Traveler0014/word-clock/hardware/preview/real-right.jpg

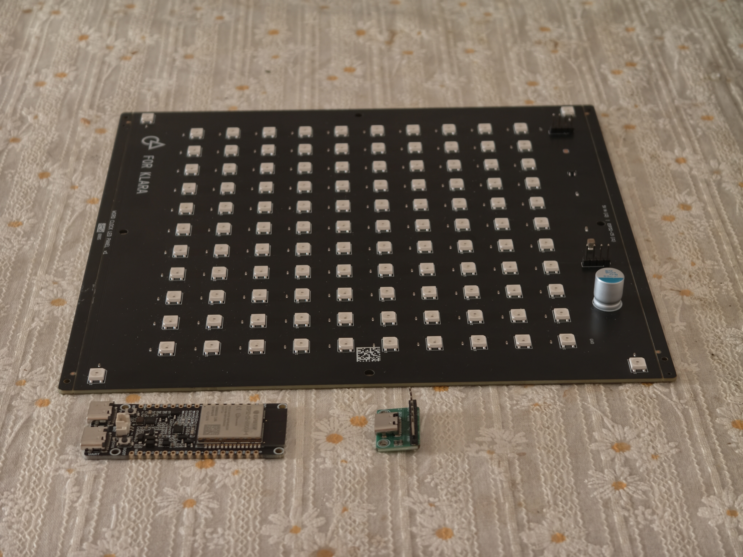
hardware/preview/real-right.jpg
