Traveler0014/word-clock/hardware/preview/real-top.jpg

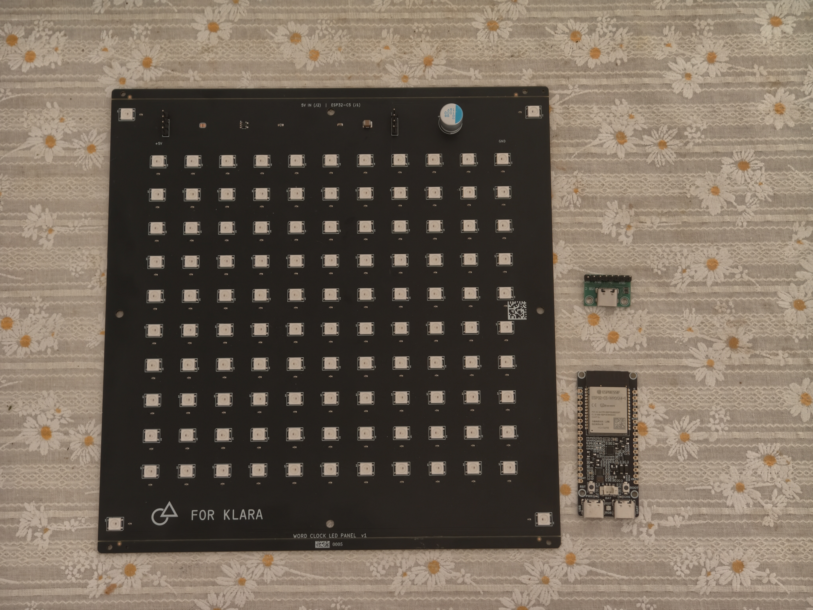
hardware/preview/real-top.jpg
