Traveler0014/word-clock/firmware/README.md

# word-clock-firmware

字钟固件（路线 A：Rust std on ESP-IDF）。**MVP 已实机点亮**。开发流程见 [docs/development.md](../docs/development.md)。

## 结构

```
firmware/
├── app/              # ESP32-C5 固件 bin（esp-idf-svc）
│   ├── src/
│   │   ├── main.rs       # 启动流程：自检 → 延迟 → WiFi → SNTP → 显示循环
│   │   ├── leddrv.rs     # WS2812B RMT 驱动封装（GPIO4，1/4 亮度限幅，自检，整帧刷新）
│   │   ├── wifi.rs       # STA 连接（WPA2、扫描确认、无限重试）
│   │   └── time_svc.rs   # SNTP（ntp.aliyun.com）+ 时区 UTC+8
│   └── sdkconfig.defaults    # UART0 主控制台、主任务栈 16K（各项有注释）
├── wordclock-core/   # 纯逻辑：时间 → LED 点阵。no_std，宿主机可测，路线B 直接复用
├── tools/uart_sniff.py   # UART 日志监听（自动重连）
├── vendor/ws2812-esp32-rmt-driver/  # vendored 驱动（适配 hal 0.46 的补丁版）
├── .cargo/config.toml        # 目标芯片 / IDF 版本 / sdkconfig 指定
└── env.sh            # 注入 IDF + esp 工具链环境
```

> 各源文件的模块级文档（`//!`）与关键行注释承载实现细节，**改代码时同步维护注释**，不要把细节搬进 README。

## 版本锁定（已验证组合，勿随意升级）

- `esp-idf-svc 0.52` / `esp-idf-hal 0.46` + **vendored** `ws2812-esp32-rmt-driver`（hal 0.46 补丁版，legacy rmt api）
- **IDF v5.5.1**（esp-idf-sys managed 安装在 `firmware/.embuild/`）
  - v6.0.2：esp-idf-sys 0.36 未适配，且 eim 的 python 环境残缺
  - hal 0.45：对 esp32c5 支持不全且与 v5.4+ API 漂移
- esp Rust 工具链 1.95.0（nightly fork，`build-std` 编译 std）

## mDNS / 组件仓库

局域网域名访问（`http://klara-clock.local/`）靠 **组件仓库的 `espressif/mdns`**：IDF v5.5
已把 mdns 从内置组件移出，本仓库通过 `app/Cargo.toml` 的
`[package.metadata.esp-idf-sys] extra_components` 声明，esp-idf-sys 会生成
`idf_component.yml` 交给 IDF 组件管理器。

- 版本锁定在 `firmware/components_esp32c5.lock`（当前 1.15.1），与 `Cargo.lock` 一样应提交
- **首次构建需访问 `components.espressif.com`**（拉下来后缓存在 `.embuild/` 与 `target/`，后续离线可编）
- 坑：本工作区是**虚拟 workspace**，`cargo metadata` 拿不到 root package，esp-idf-sys
  会**静默忽略** `[package.metadata.esp-idf-sys]`（只打一条 warning 就继续，表现为
  “配了没效果”、`out/main/idf_component.yml` 根本没生成）。必须在
  `firmware/.cargo/config.toml` 里设 `ESP_IDF_SYS_ROOT_CRATE = "word-clock"`
- hostname 与 DHCP option 12 共用设置项（`settings.name`）；服务实例名固定
  `KLARA Clock`，通告 `_http._tcp` 80
- Android 原生不解析 `.local`（需额外 App），iOS/macOS/Windows/Linux(Avahi) 可直接用

## 板子差异（务必确认！）

| 模组 | flash | PSRAM | 本仓库配置 |
| --- | --- | --- | --- |
| **ESP32-C5-WROOM-1-N32R8**（2026-10 起的新板） | 32MB | 8MB | 当前 `app/sdkconfig.defaults` 的目标 |
| ESP32-C5-WROOM-1-N16R8（旧板） | 16MB | 8MB | 需删掉 `CONFIG_ESPTOOLPY_FLASHSIZE_32MB` |

flash 相关配置（`app/sdkconfig.defaults` 有逐条注释，别随手改回默认值）：

- `CONFIG_ESPTOOLPY_FLASHSIZE_32MB=y` —— 默认值是 2MB，与实物不符时 app 镜像头的 flash size 错误
- `CONFIG_ESPTOOLPY_FLASHFREQ_40M=y` —— **红线**：N32R8 在 DIO 80MHz 下取指不可靠，
  release 全量 app 会在 `call_start_cpu0 → esp_mmu_map_init`（flash 时钟切换后执行的第一段
  flash 常驻代码）拿到非法指令，打印 `Guru Meditation (Illegal instruction)` 后无限重启。
  诡异之处：debug 版和小体积的 `--features diag` 版不触发，只有 release 全量包中招——
  排查时别被“debug 能跑”骗了。
- 分区表 `app/partitions.csv`：factory 4MB（默认 singleapp 只有 1MB，装不下 1.46MB 的 release 包）。
  esp-idf-sys 无法把自定义 CSV 交给 IDF 的 CMake，所以由 espflash 直接消费，烧录命令见 `AGENTS.md`。

## 网络

构建（凭据不进固件，首次上电经配网页面写入 NVS，详见 docs/development.md）：

```bash
cargo build -p word-clock   # 不需要 WiFi 凭据：首次上电用配网页面写入
```

国内构建加速（IDF 组件/GitHub 资产代理）如需，参考：

```bash
GIT_CONFIG_COUNT=1 \
GIT_CONFIG_KEY_0='url.https://gh-proxy.com/https://github.com/.insteadOf' \
GIT_CONFIG_VALUE_0='https://github.com/' \
IDF_GITHUB_ASSETS='dl.espressif.com/github_assets' \
cargo build -p word-clock
```
