Traveler0014/word-clock/enclosure/stl/pcb_v4/preview/all_iso.png

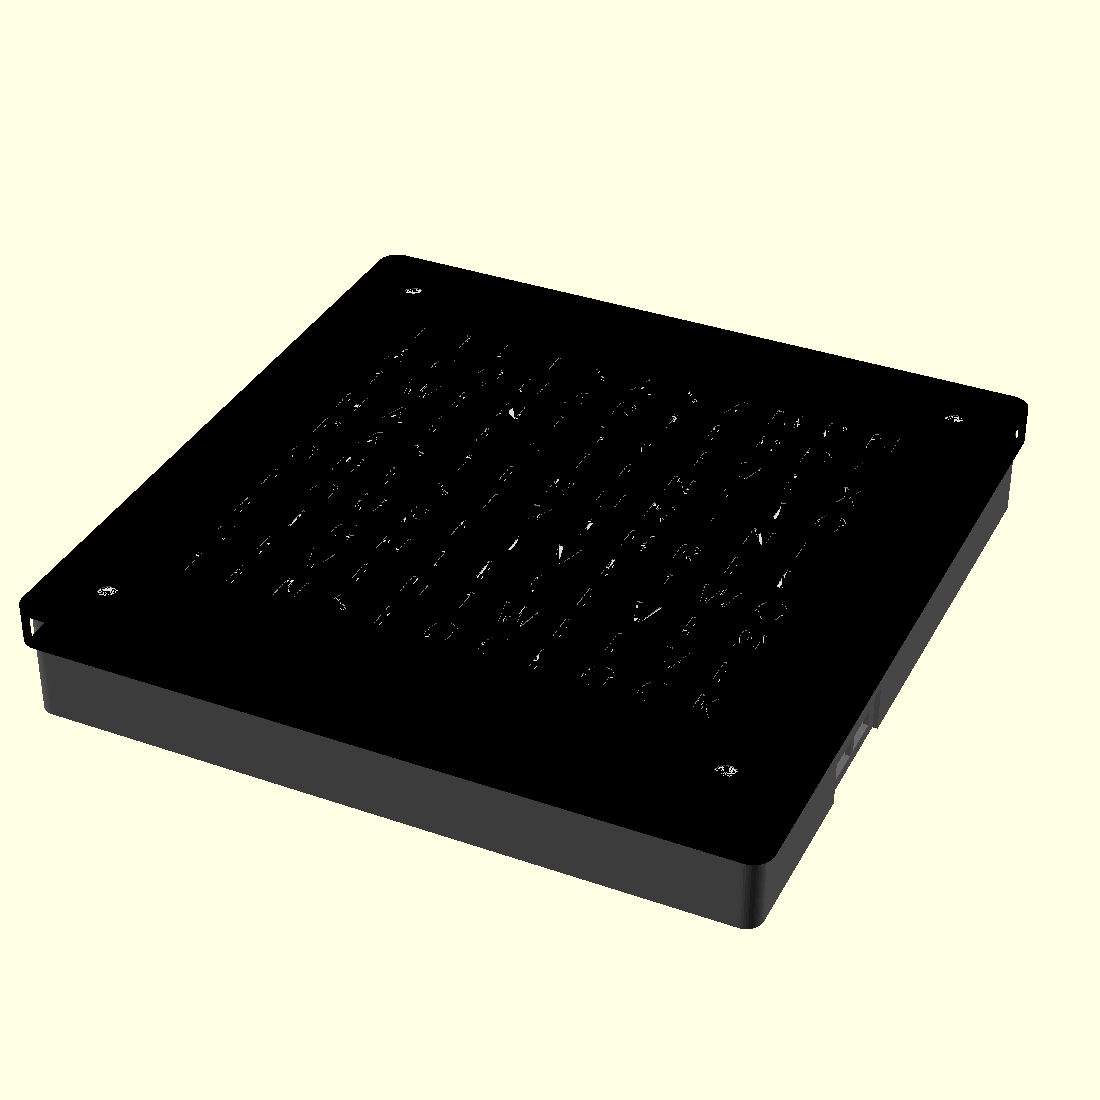
enclosure/stl/pcb_v4/preview/all_iso.png
