Traveler0014/word-clock/enclosure/stl/pcb_v4/preview/body_iso.png

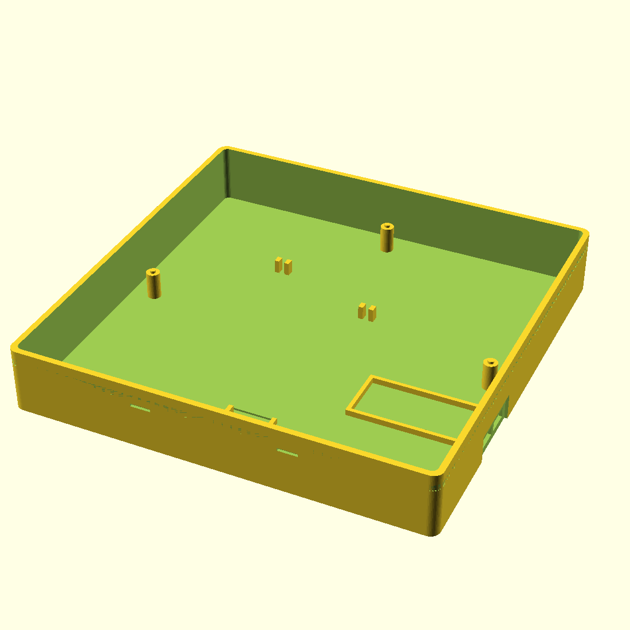
enclosure/stl/pcb_v4/preview/body_iso.png
