Traveler0014/word-clock/enclosure/stl/pcb_v4/preview/coupon.png

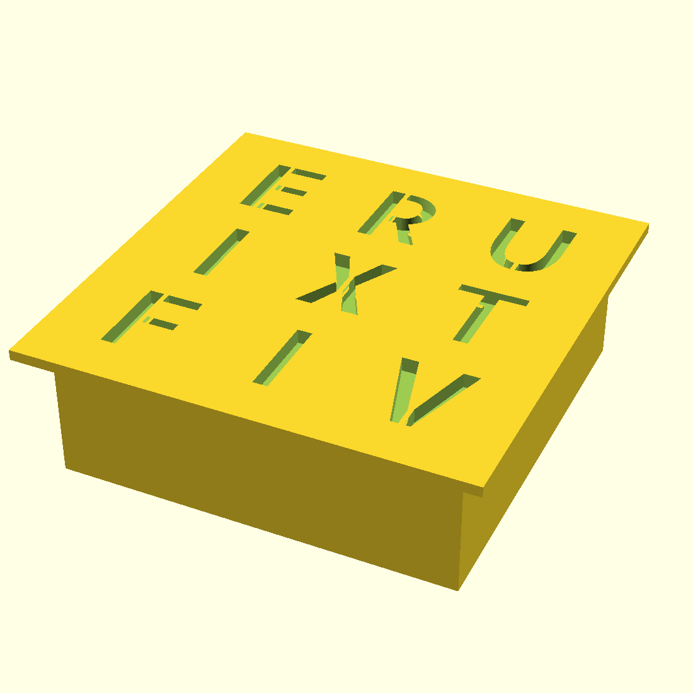
enclosure/stl/pcb_v4/preview/coupon.png
