Traveler0014/word-clock/enclosure/stl/preview/backplate.png

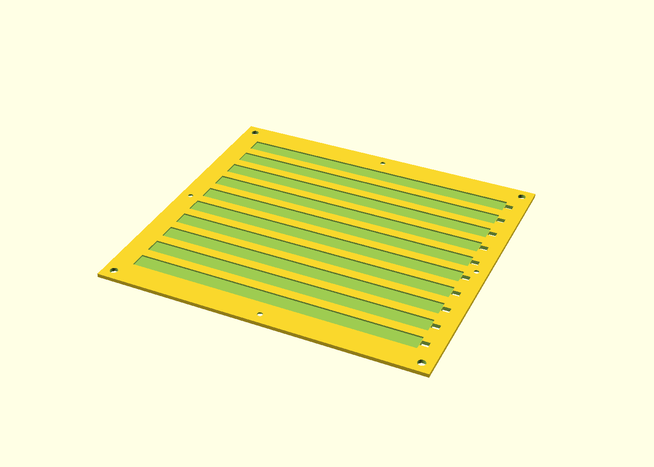
enclosure/stl/preview/backplate.png
