Traveler0014/word-clock/enclosure/stl/preview/corner_ring.png

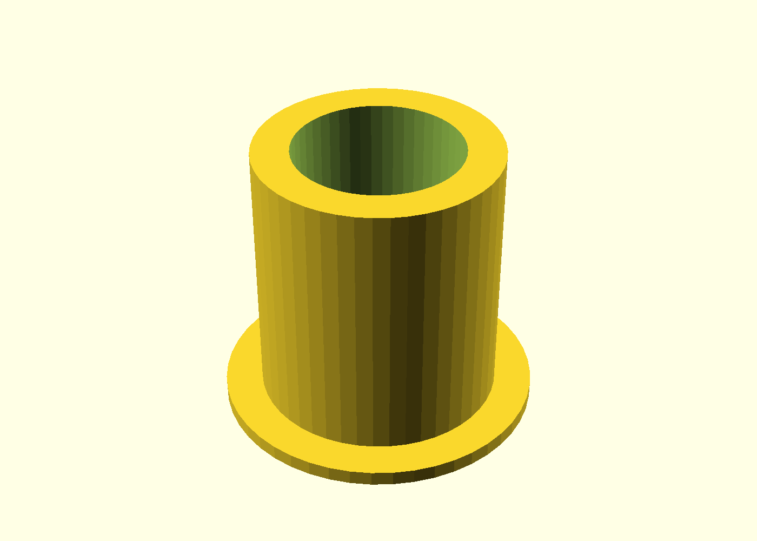
enclosure/stl/preview/corner_ring.png
