Traveler0014/word-clock/enclosure/stl/preview/faceplate_allerta_front.png

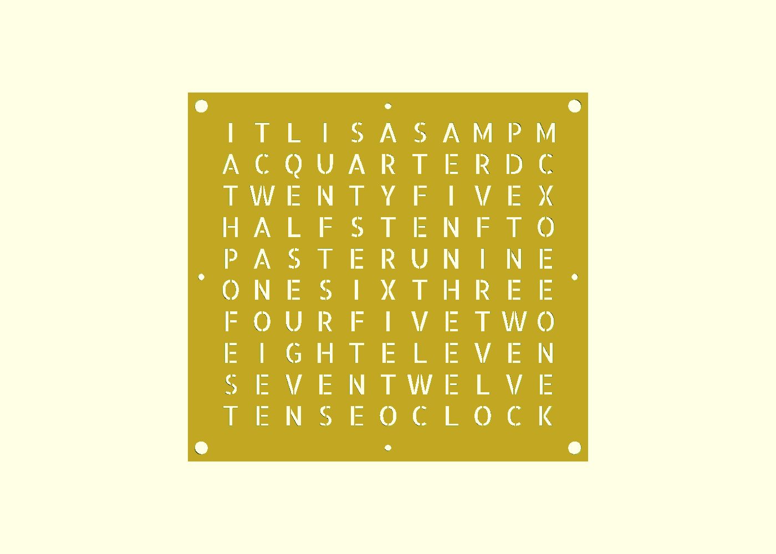
enclosure/stl/preview/faceplate_allerta_front.png
