Traveler0014/word-clock/enclosure/stl/preview/pitch_jig.png

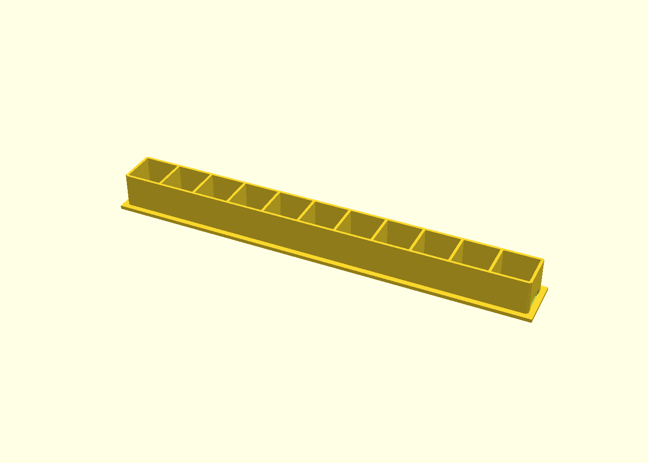
enclosure/stl/preview/pitch_jig.png
