Traveler0014/word-clock/hardware/preview/pcb_bottom.png

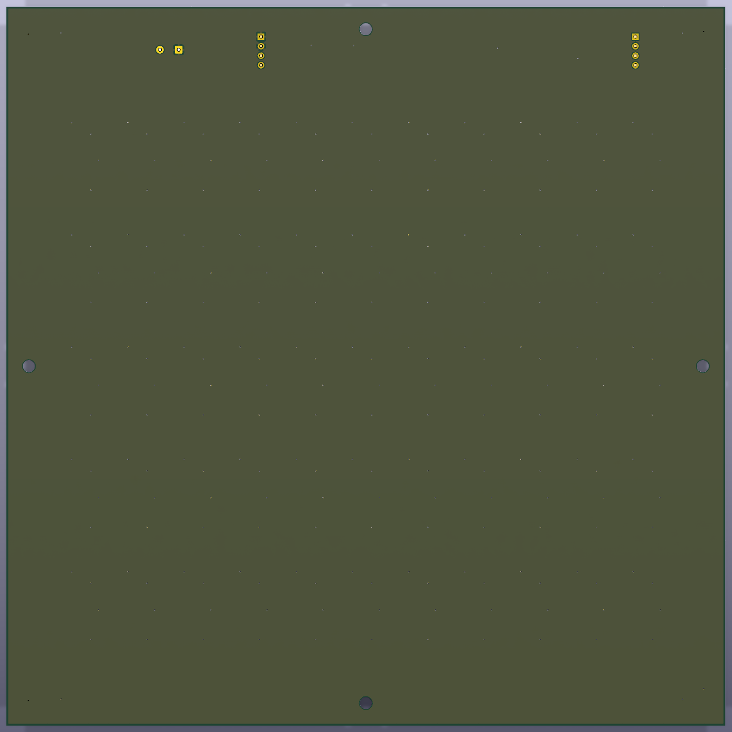
hardware/preview/pcb_bottom.png
