Traveler0014/word-clock/hardware/preview/pcb_top.png

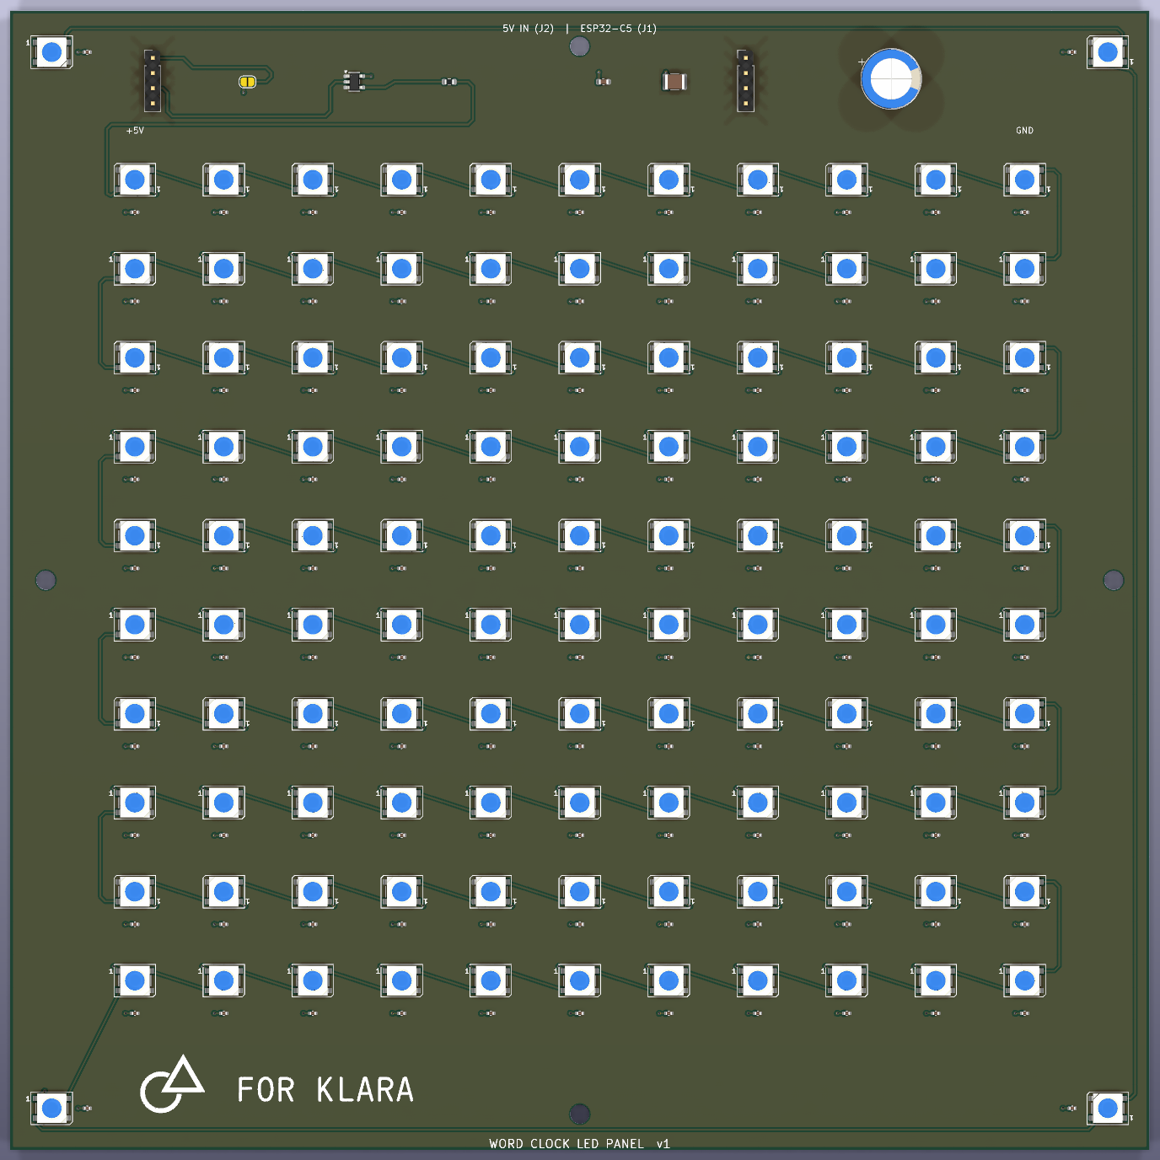
hardware/preview/pcb_top.png
