Traveler0014/word-clock/hardware/preview/real-front.jpg

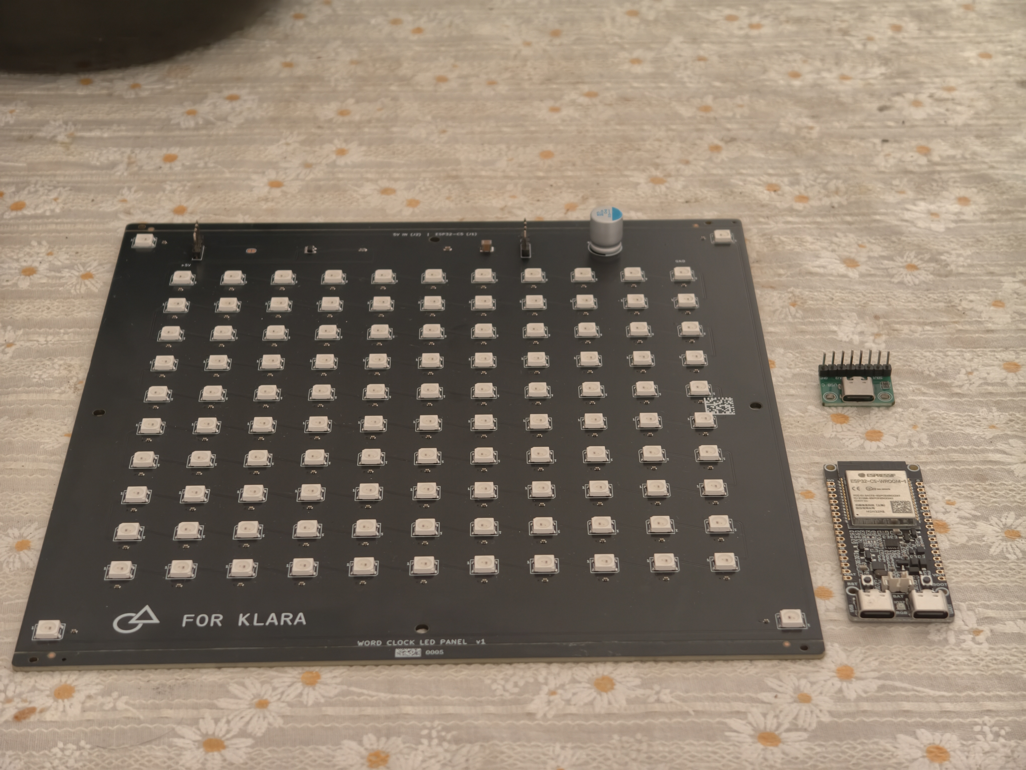
hardware/preview/real-front.jpg
