Traveler0014/word-clock/docs/bom.md

# BOM 物料清单

## 已有

| 物料 | 规格 | 备注 |
|---|---|---|
| ESP32-C5-DevKit | 双 USB 口：UART（CH9102F）= 日志主控，USB-JTAG = 烧录/调试 | 双线常驻，详见 docs/development.md |
| WS2812B 灯条 | 60灯/米 | 需 114 颗 ≈ 1.9m |
| 拓竹 3D 打印机 | 250×250×250 | 结构件 |

## 待购

| 物料 | 规格建议 | 用途 | 参考价 |
|---|---|---|---|
| 5V 电源 | 5V/4A + DC 母座（或 USB-C PD 诱骗 5V 模块） | 供电 | ¥20-40 |
| 电平转换 | 74AHCT125 或 74HCT245 | 3.3V→5V 数据线 | ¥2 |
| 电容 | 1000µF/16V 电解 | 灯条电源缓冲 | ¥1 |
| 电阻 | 470Ω ×1 | 数据线串联 | ¥0.1 |
| 光敏电阻 | GL5528 + 10kΩ 分压电阻 | 自动亮度 | ¥2 |
| DS3231 RTC 模块 | 可选 | 断网/断电守时 | ¥8 |
| 电线 | 22AWG 硅胶线（红黑+信号色） | 行间/供电 | ¥10 |
| 洞洞板或打样 PCB | 小尺寸 | 电源分配 + 电平转换 | ¥5 |
| 扩散材料 | 硫酸纸 或 1mm PC 光扩散板 | 匀光 | ¥10 |
| 镂空字车贴 | 定制（前面板方案 B 时） | 字母面板 | ¥20-40 |
| 黑色哑光 PLA | ~300g | 结构件 | 已有? |

预算小计（除已有）：约 ¥80-150。

## 功率预算

- 理论满亮：114 × 60mA ≈ 6.8A（软件限亮度，不会达到）
- 实际最大同时点亮 ≤ 28 颗 ≈ 1.7A @满白；限亮 1/4 后 < 0.5A
- 5V/4A 电源裕量充足；灯条首尾两处注入供电
