Traveler0014/word-clock/hardware/pcba.step

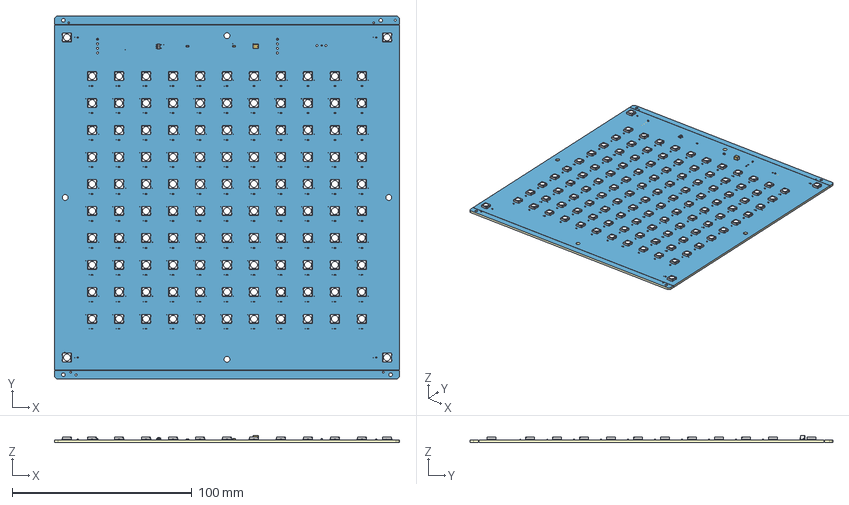
[picture p15: CAD file, 2026-10-18]
hardware/pcba.step
191.8 x 201.8 x 4.10 mm
Board~HXHu
TopCopper~HXHu
BottomCopper~HXHu
TopSilkscreen~HXHu
BottomSilkscreen~HXHu
TopFpcStiffener~HXHu
BottomFpcStiffener~HXHu
插件,P=2.54mm~4d681f2b089e4a80aeb260fea449d12e~HXHu x 2
插件,10x11mm~c72858c1156342dc8d04381236487e15~HXHu
0603~undefined~IkkK
0402~undefined~UgZe x 114
SMD5050-4P~undefined~3BTE x 114
0603~undefined~5JLm
SOT-23-5L~undefined~H7Fi
1210~undefined~EHFG
