Traveler0014/word-clock/(list of files, cad)

Other CAD files:
enclosure/scad/wordclock.scad
