Traveler0014/word-clock/enclosure/stl/preview/all_assembly.png

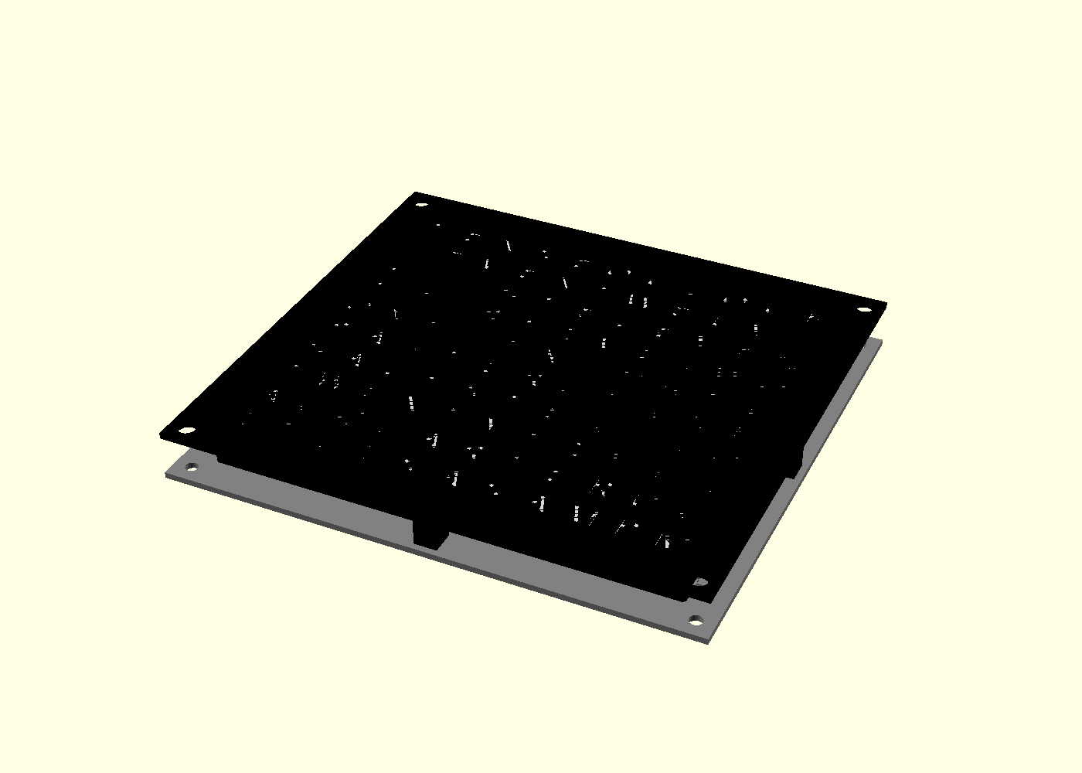
enclosure/stl/preview/all_assembly.png
