Traveler0014/word-clock/enclosure/stl/pcb_v4/preview/snap_test.png

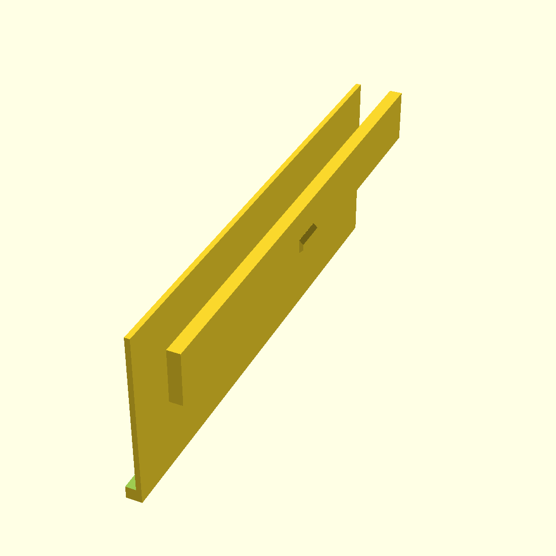
enclosure/stl/pcb_v4/preview/snap_test.png
