Traveler0014/word-clock/hardware/wordclock-led-sch.pdf

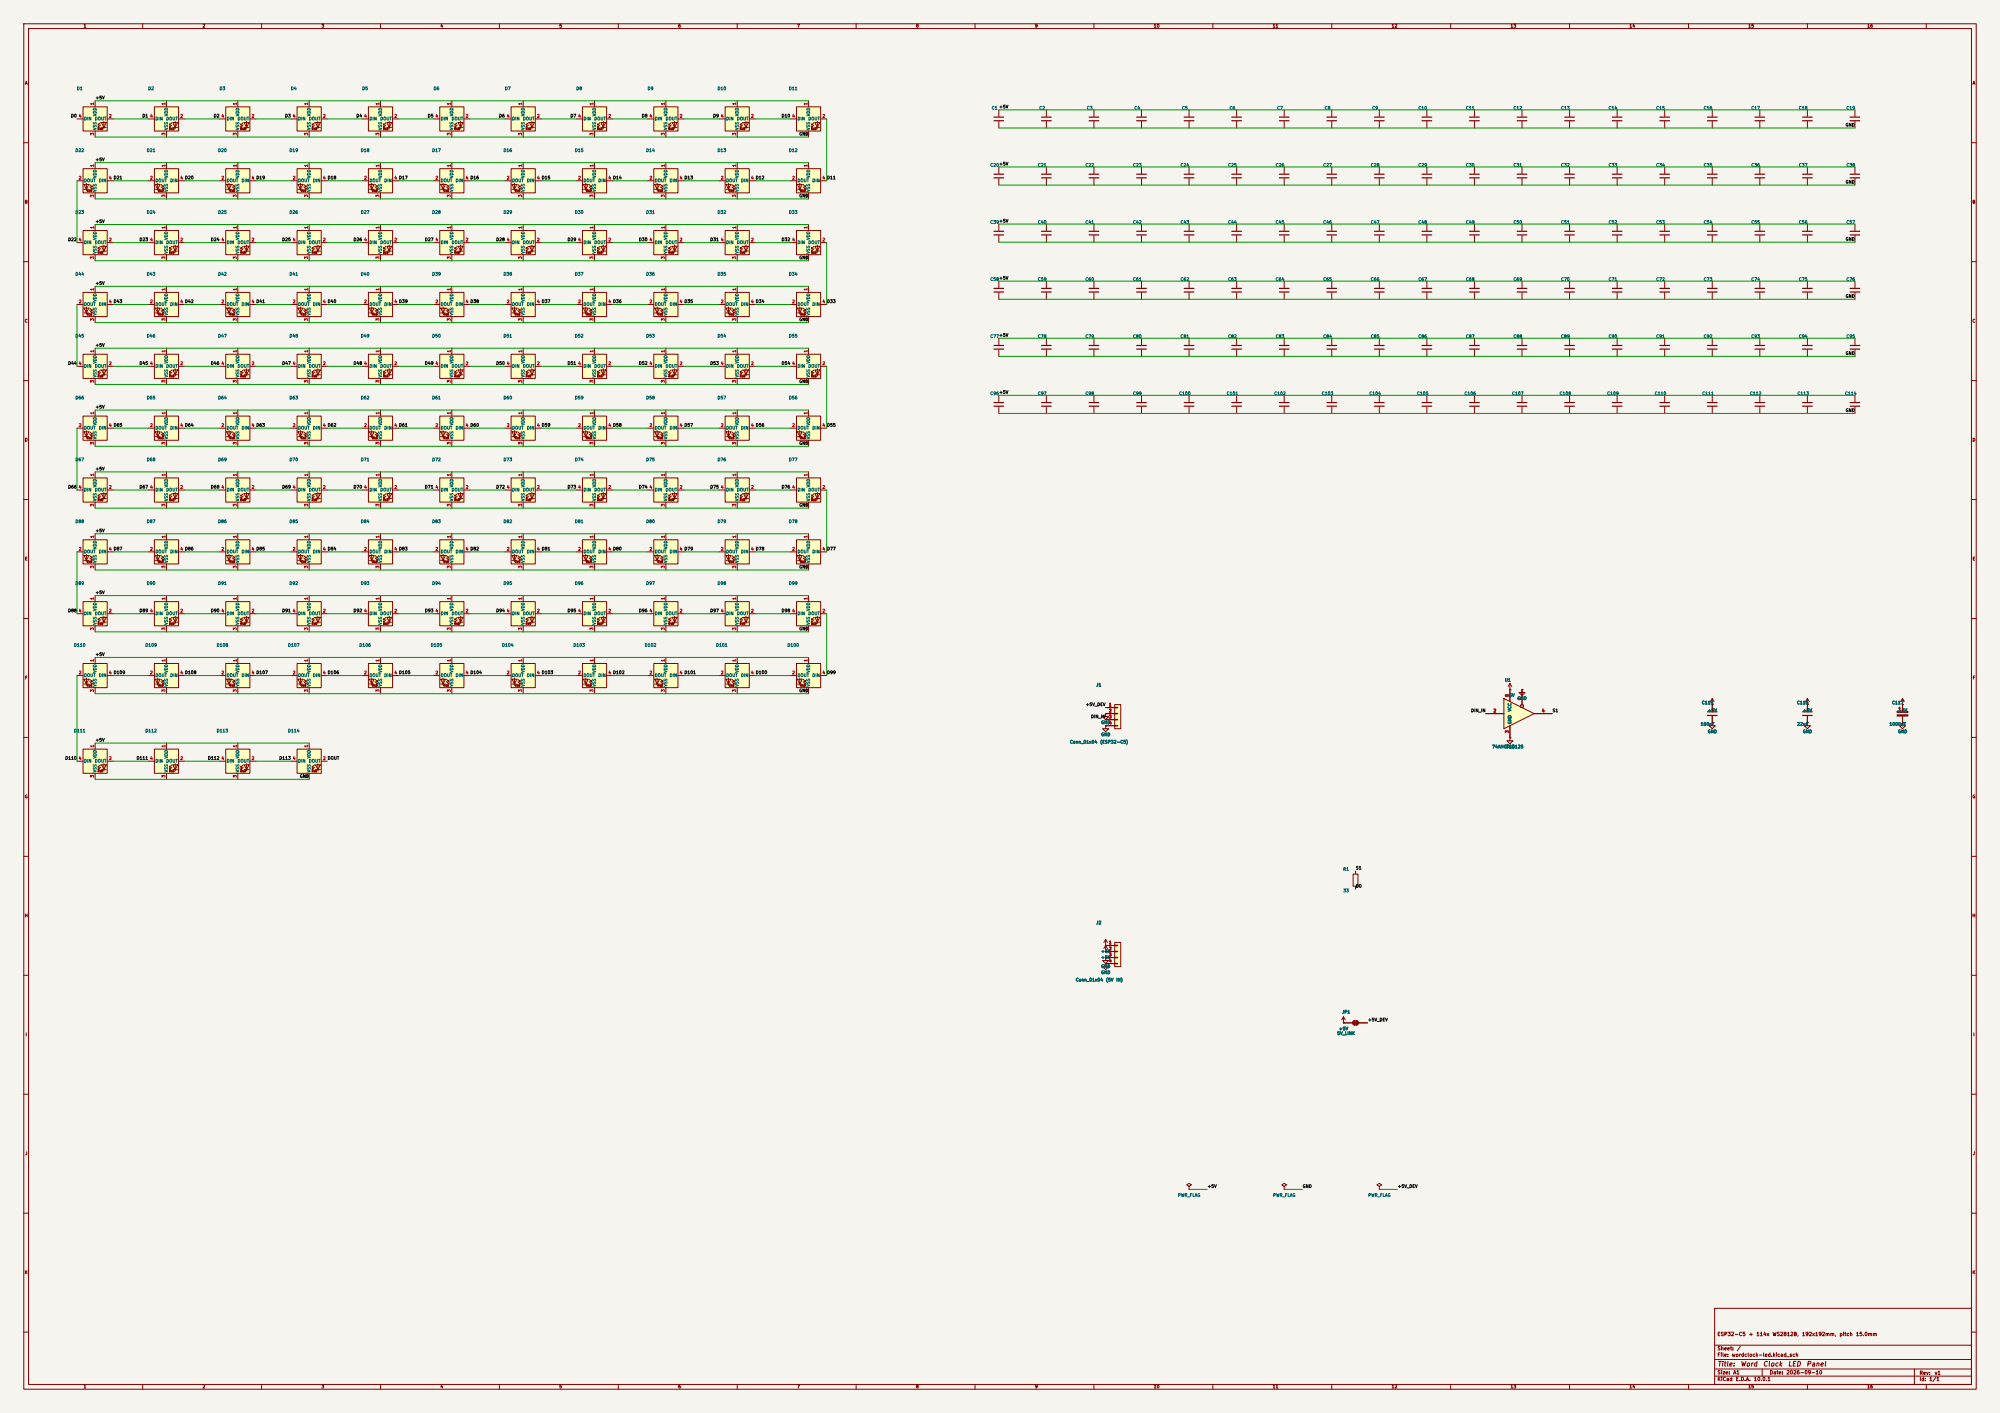
[picture p18: page 1]

Sheet: /
File: wordclock-led.kicad_sch
Title: Word Clock LED Panel

Size: A1 | Rev: v1
KiCad E.D.A. 10.0.1 | Id: 1/1
