Traveler0014/word-clock/(commit log)

2026-07-19 init: route-A MVP scaffold — esp-idf-svc app + no_std wordclock-core (9 host tests passing)
2026-07-19 init: BOM, wiring diagram, roadmap
2026-07-19 init: parametric OpenSCAD enclosure (grid/backplate/faceplate) for 60LED/m 11x10 layout
2026-07-19 feat: 路线A MVP 编译通过 — svc 0.52/hal 0.46 + vendor ws2812(hal0.46) + managed IDF v5.5.1
2026-08-30 fix: 显式指定 SDKCONFIG_DEFAULTS + 主任务栈 16K（实测栈溢出修复）
2026-08-30 docs+chore: MVP 点亮后整理
    - README: 更新为 monorepo 结构，记录双 USB 口分工与实机点亮状态
    - firmware/README: 版本锁定修正（svc0.52/hal0.46/IDF5.5.1）、
    烧录与日志流程、五条实测踩坑记录（auth_method/重启循环/栈/监听干扰/主控制台）
    - docs/roadmap: MVP 清单勾选（工具链/编译/实机刷写完成）
    - docs/wiring: 补充 4 灯样本验证阶段接线与实测结论
    - tools/uart_sniff: UART 日志监听（dtr/rts 必须为 False，否则摁住 IO0 进下载模式）
    - vendor/app: legacy rmt api deprecation 警告压制（vendor 补丁版锁定旧接口）
2026-08-30 docs: 文档重组 — README 导航化，功能文档拆分 docs/，实现细节随代码注释
    - README: 精简为简介 + 目录/文档导航
    - docs/development.md: 新增开发指南（环境/烧录/日志/时序注意/踩坑索引）
    - firmware/README: 精简为结构与版本锁定，细节指向代码注释
    - AGENTS.md: agent 快速上手指南（命令/硬件铁律/代码红线/验证顺序）
    - 修复 subtree 迁移回退：重新应用 wifi auth+重试+扫描诊断、
    main 启动延迟与阶段重试、time_svc NTP 状态日志（板载已验证版本）
    - bom: 双 USB 口描述修正
2026-08-30 feat(scripts): Windows 侧 usbipd 一键 bind/attach/detach/unbind 脚本
    - usb-up.ps1: bind + 后台 auto-attach 常驻（断线/重枚举自动重连，防重复启动）
    - usb-down.ps1: 停 auto-attach → detach → unbind（-KeepBind 保留 shared）
    - docs/development、AGENTS 挂链接
2026-08-30 chore: MIT LICENSE + .gitattributes（ps1 CRLF / 仓库 LF）+ README 补英文简介与协议
2026-10-18 feat(led): 改用 rmt_write_items，修复 WiFi 下丢位花屏
    现象：字钟显示缺字母、后段整片全白/全黑，且图案每次不同。
    根因：vendor 驱动走 TxRmtDriver::start_iter_blocking()，该 API 把
    "把位流喂给 RMT" 放进 RMT 中断里用 Rust 迭代器完成（esp-idf-hal
    rmt_legacy.rs 的文档本身就警告过 this）。WiFi 一开中断就被抢占 →
    供数欠载 → WS2812 提前锁存，后段灯保持旧帧。
    改法：
    - 帧先编码成 VariableLengthSignal 放 RAM，再 start_blocking()
    → IDF 自己的 rmt_write_items 在中断里从 RAM 搬运，不再回调 Rust
    - mem_block_num 1 → 4，给欠载留余量
    - 新增 show_with(color, div) 支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
2026-10-18 feat(web): 凭据进 NVS + SoftAP 配网 + 局域网管理页
    配网（无凭据或连不上时自动进入）：起开放热点 WordClock-XXXXXX
    （地址固定 192.168.9.20），页面为两步向导"选网络 → 输密码"，可顺带
    设置管理口令；手机侧按 navigator.language 显示中/英。
    强制门户：DNS 劫持（UDP:53 所有 A 查询都答成 AP 地址）+ HTTP 通配
    兜底 302 + DHCP option 114（RFC 8910）+ esp_netif_set_dns_info 把
    DHCP 的 DNS 指向自己 —— 少了最后一步，客户端拿到的 DNS 不是设备，
    探测请求根本发不出来。
    运行期管理页（http://<设备IP>/）：状态、亮度/色温/时区、管理口令、
    更换网络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
2026-10-18 chore(tools): 宿主机排查工具与 Windows 设备脚本
    tools/
    - uart_sniff.py：按 VID:PID 自动找 UART 口（ttyACM 编号会漂移），
    dtr/rts 在 open 前置 False（否则每次打开都把芯片复位）
    - frame_preview.py：打印任意时刻应亮的字母阵，--decode 用实物观测反查走线假设
    - debug_web.py + debug_web.html：浏览器点选实测亮灯，服务端算映射假设排名
    - watch_clock.py：逐分钟独立校核固件日志（重算应亮灯数 + 检测漏分钟）
    - reboot_board.py：复位板子观察自检闪灯
    scripts/windows/
    - usb-up.ps1：bind 失败自动回退 --force（本机有 USBPcap/hrdevmon 过滤驱动），
    失败不再静默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
2026-10-18 feat(hw): 灯板 PCB（KiCad + Gerber + 生成脚本）与结构件 v3
    hardware/：把原方案 10 行灯条 + 27 处行间飞线替换成单块 192×192mm
    LED 面板 PCB（方案 A：灯板 + 现有 ESP32-C5-DevKitC）。
    - 原理图/PCB（KiCad，平坦单页：114 颗灯 + 电平转换 + 电源接口）
    - 原理图 PDF、Gerber + 钻孔 + JLC 打样包、3D 预览图
    - gen/gen_sch.py（纯标准库）与 gen/gen_pcb.py（KiCad 自带 python）
    保证设计可复现、可脚本调整
    - 排除 .history/（编辑器本地历史）
    enclosure/：PCB 版结构件（faceplate/shell/grid/diffuser/装配 3mf 与预览）
    docs/led-pcb.md：灯板方案评估（尺寸与 pitch 决策、电学设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
2026-10-18 chore: 硬件产物按二进制处理 + firmware/README 编译说明
    - .gitattributes：hardware/fab/**、*.kicad_{pcb,sch,pro}、*.step 标记为
    binary，避免 `* text=auto eol=lf` 把 Gerber/KiCad 的换行改写掉
    （打样文件应与送厂字节一致，也消除提交时的 CRLF 警告）
    - firmware/README.md：编译不再需要 WIFI_SSID/WIFI_PASSWORD，凭据只存 NVS
2026-10-18 feat(tools): 灯板动效实验台（浏览器预览）+ 动效设计草案
    在落到固件之前，先在浏览器里把 114 灯动效摸清。
    tools/anim_lab.html（单文件、无构建、无依赖）：
    - 几何照抄结构件：pitch 16.58mm / 字高 10.5mm / 格栅壁 1.2mm /
    四角光腔 9mm / Allerta Stencil（Google Fonts，缺网时回退衬线）
    - 忠实模拟硬件：α → gamma 2.2 → 8bit → 可选时间抖动，显示区展示
    最大/平均码值，暗部跳台阶在网页上就能看见
    - 仿实体观感：镂空字母 + 扩散（多级模糊泛光）+ 格栅压暗 + 相机曝光
    （曝光只放大预览，不改导出值）
    - 8 个状态母题可切：星场 / 柔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
2026-10-18 feat(tools): 星空语言 v2 —— 状态 = 对同一片星空的六轴调制
    原来每个状态一个独立母题（扫带/涟漪/chase/渐现…），摆在一起像八个人
    各写一套字。改成同一片星空的不同"物理"，视觉上才像一个世界。
    六个轴：rate（快慢，0=冻结）· peakMul（整场明暗，含 tide 潮汐）·
    coh（相位收拢=同相）· gate（星等门槛=进度）· hue（色调偏移）·
    event（流星/星落/余烬）。十个状态预设见 docs/animation.md。
    两个关键决定（都用实验台验证过）：
    - 风必须是衰减式而非加成式：加成让星亮到码值 160~210，比时间文字还亮，
    层级塌了；衰减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
2026-10-18 feat(tools): 实验台拆成两套主题 + 修下拉框可读性 + 暴露 v2 参数
    - 两套方案并列为主题：星空语言 v2 / 旧母题 v1。主题决定"状态列表 +
    参数面板 + 序列脚本"，方便对照，也为将来"主题 = 一份描述符"铺路
    - 原生 select 在 Windows 上白底灰字看不清 → 自绘（appearance:none +
    深底浅字 + ▾ 箭头 + option/optgroup 同步配色）
    - v2 的可调数值全部暴露：风（周期/宽度/低谷倍）、潮汐（周期/最暗倍）、
    流星（间隔/时长）、余烬（搏动）、升级（演示时长）、停滞（抽搐间隔）
    - 关键分层：LANG 表只声明"哪些调制生效"（结构），数值全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
2026-10-18 feat(tools): 单一解释器 + 两份描述符（两套主题只换配置）+ 固定状态清单 + 过渡层
    回答两个问题，都在实验台里做成了可运行的东西：
    1) "方案1 能否只换配置就得到两套主题" —— 能。删掉双代码路径，现在只有
    一个解释器 + 一组封闭生成器，两套主题就是两份描述符（THEME_DESC）。
    同一状态下实测差异：wifi_connecting 在 stars 主题是 29 盏/峰值 0.51，
    在 motifs 主题是 101 盏/峰值 0.88（加性光带把面板点亮到接近白）。
    为此模型补了三样东西：状态可覆盖星场的乘性调制（rate/peakMul/hue/
    wind/tide/cohere/gate/fall/twitch）、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
2026-10-18 feat(tools): 参数面板按生成器重构 + 主题可编辑/上传 + 开屏名字星座
    1) 参数面板整体重做，与生成器模型对齐：
    - 星场（全局身份参数）
    - 状态编辑器：按当前主题、当前状态生成控件 —— 星场覆盖（rate/peakMul/
    hue/cohere/gate/fall/twitch/wind/tide/freezeAt，勾选即启用）+ 叠加层
    生成器卡片（每个生成器带自己的参数与 blend，可增删）
    - 渲染（gamma/抖动/色温/泛光/曝光/格栅/进度演示）
    - 描述符 JSON 逃生口（粘贴即用）+ 导出
    生成器参数改为"描述符优先 + 内置默认"，P 只保留星场身份/渲染/演示。
    2) 主题可编辑与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
2026-10-18 fix(tools): 去掉重复的主题切换入口 + KLARA 改为慢速渐亮渐隐、两个 A 散开
    - 主题切换只保留侧栏下拉（播放栏那对按钮删掉）：它还能管自定义主题，
    两处入口容易互相覆盖 P.theme
    - spell 生成器重写：
    * 每个字母独立包络"渐亮 → 停留 → 渐隐"（新增 fadeOut、delay 参数），
    原来是一次性亮起再留余晖，节奏太快
    * 选格不再复用已用格子；同一个字母第二次出现时要求离上次至少 spread 格
    → KLARA 的两个 A 散开成 (4,1) 与 (1,4)，像两颗星而不是重复同一个格
    * 默认 step 0.38 / fade 0.50 / hold 0.70 / fadeOut 0.55 / delay 0.40
    - 开屏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
2026-10-18 feat(tools): 融合主题 v3 + 光效语义框架（错误用"降级显示"表达）
    按"先定语义，再谈效果"重做：
    1) 语义框架（写进 docs/animation.md）
    - 五个通道：存在感（星场）/ 方向的进展（扫带、星等门槛）/ 周期等待（潮汐、
    角点 chase）/ 一次性事件（流星、涟漪、滴答）/ 系统级状况（角点搏动、降级）
    - 三条硬规则：亮度分级=注意力分级；一个状态只用一注意通道；语义必须挂在
    离散结构上（人对明暗/快慢不敏感，对"哪些字母亮"极敏感）
    2) 两个实测结论
    - 不能用字母拼标签词：字母阵只能读出数字词，NET 会被选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
2026-10-18 feat(tools): 标签词按阅读顺序选格 + "K 是我"的语言约定 + 修蛇形逆映射 bug
    1) 标签词（NET/SYNC/OTA/TIME）恢复使用：用户判断对——散落字母点会让人
    自然组成那个短词，这是这块面板独有的表达能力。关键是选格规则：
    - 新增 resolveLabel()：第 k 个字母落在 (k+0.5)/n 位置附近，且行主序
    严格递增（必要时回绕）→ 三点散开、按序、不会拼出反序假词
    - 反例记录：按"最近邻"选格时 NET 被选成 (9,2)N→(9,1)E→(9,0)T，
    空间上连成 "TEN"
    - 拼写 KLARA 仍用最近邻连线（名字要像星座被画出来），spread 3→6
    2) 新增语言约定："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
2026-10-18 feat(tools): 标签/名字改为写死点位（cells），算法选点仅用于藏彩蛋
    用户的判断是对的：想要"一眼读出"就不能靠算法分散。现在把两种设计意图
    分开：
    - 描述符写 cells: [[r,c],...] → 按人工摆好的紧凑一簇点亮（readable）
    - 只给 letters/text → 算法选点、分散到各处（easter egg：让人自己发现）
    实测跨度（行差×列差，越小越好认）：
    NET 6×7 → 1×3 SYNC 9×5 → 2×5
    OTA 2×9 → 1×3 TIME 8×4 → 2×2
    融合主题最终点位（拼接结果已逐一校验 == 目标词）：
    - KLARA: K(9,10)→L(7,6)→A(4,1)→R(1,5)→A(0,5) 右下→左上
    - NET: N(2,3) E(3,6) T(2,4)（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
2026-10-18 feat(tools): 单向性成为可读性的硬约束 + 时序单向性回退
    用户的判断：左右/上下不可能同时单调，所以只要求**一条轴**严格单调；若某词
    在板上找不到任何单轴单调的摆法，就改用**时间**维持单向性（逐个渐亮渐隐）。
    1) monotonicInfo(cells)：检测方向与跨度。英文词只认"列→"（退一步"行↓"）；
    名字拼写允许任意方向单调（方向即语义：右下→左上"升起"）
    2) resolveLabel 从启发式改成**有约束的穷举搜索**：列→ 优先、其次 行↓，
    目标函数 = 最小跨度 + 最短路径。算法选字与手选字从此用同一标准
    3) 现行点位全部通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
2026-10-18 feat(tools): 运行态星空改为"静止 + 极暗"，闪烁预算留给异常状态
    日常读时的目标是读时间，不是看动效。默认配置：
    - running: stars{rate:0, peakMul:0.30} → 星空完全静止，最亮星码值≈15
    - 唯一活动元素是 planet 暖点的 14s 极慢呼吸（码值 1~7）
    - 深夜态没有文字，动态即内容 → 保留闪烁（peakMul 0.75, planetMul 1.4）
    顺带修正一处自相矛盾：框架规定"文字 255 > 标签 60~90 > 星场 8~20"，但运行态
    星场峰值原本是 α 0.6（码值 81），已经落在"标签"层，与时间文字抢注意力。
    另外补回 planet：生成器重写时被漏掉，只剩 UI 控件。现在由 genSta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
2026-10-18 fix(tools): 补回 markQuiet/setQuiet（上一版补丁锚点带缩进没匹配上）
    现象：页面抛 Uncaught ReferenceError: markQuiet is not defined。
    原因：加"运行时星空 A/B"时用带两格缩进的字符串做锚点替换，而文件里那行是
    顶格，替换静默失败 → markQuiet() 在启动序列里被调用但没有定义。
    修法：把 QUIET / markQuiet / setQuiet 显式插到第 12 节之前（全局作用域），
    并在脚本里加了锚点断言，避免再次静默失败。已实测三个按钮各自把
    running + minute_change 的 {rate, peakMul} 改成 0/0.30、0.15/0.35、1/1，
    按钮高亮与描述符内容同步。
2026-10-18 feat(tools): WIFI/WAIT/AP 三个标签 + 新增 wifi_scanning 状态
    按"能用 3~4 字母名词概括就用标签"的标准补三个状态：
    - ap_start → AP A(0,7) P(0,9) 列→ 0×2（板上最紧的一对）
    - wifi_connecting → WIFI W(2,1) I(0,3) F(2,6) I(2,7) 列→ 2×6
    - provisioning_wait → WAIT W(2,1) A(1,4) I(2,7) T(3,9) 列→ 2×8
    （原来的四角点 chase 去掉——一个状态只用一个注意通道）
    新增 wifi_scanning：固件 web.rs 里本来就有 scanning 这个逻辑阶段
    （setup: idle|scanning|connecting|ok|fail），但灯效上没有对应状态，扫描时
    面板还在显示"等待配置"。现在补上，并且**不用标签**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
2026-10-18 feat(tools): 扫描改为"WIFI 常亮 + 纵向快扫"（身份层与注意层分离）
    用户提出更好的组合：WIFI 常亮/高亮 + 扫描动效。这推进了"一个状态只用一个
    注意通道"的规则——**常亮不闪的标签不占注意通道**，它是身份/上下文：
    - 新增 label 模式 steady（全字母常亮、不闪）
    - wifi_scanning = WIFI(steady 0.50) + band(轴 y, 0.55s/轮, 宽 0.75, 峰 0.46)
    → 读作"WiFi 这一层正在逐条信道找"；同时不再需要造 SCAN 这个词
    （SCAN 在板上排不出单向阵型，最紧 9×5）
    - ota_apply 采用同一模式：OTA(steady 0.55) + 斜向慢扫 → "正在写入"
    - 编辑器 mode 下拉补 steady / s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
2026-10-18 feat(tools): 扫描/连接的动效对调——慢横向扫 vs 快对角扫
    - wifi_scanning（耗时操作）：WIFI 常亮 + **沿标签阅读方向的横向慢扫**
    （axis x，2.4s/轮，左→右）。"扫的方向 = 读的方向"，眼睛会把"光在往右
    走"自动读成"正在依次检查"
    - wifi_connecting（短促握手）：WIFI 常亮 + **快速对角扫**（axis diagr，
    0.75s/轮），与开屏同一手势家族
    - 两者共用 WIFI 常亮作为身份层，差异全部由运动的速度与方向承担
    docs 新增"动效的速度/方向要跟事情的性质对齐"：耗时=慢+顺读向；握手=快+对角；
    成功=一次性事件；不可中断=常亮+缓慢连续扫。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
2026-10-18 feat(firmware): 把动效模型搬进固件并接上所有可观测状态
    core（wordclock-core/src/anim/）
    - State 枚举（15 态，固件拥有；主题只决定表现）
    - 星表：mulberry32 固定种子 + 星等分级，每次开机同一片星空
    - 生成器：星场（乘性调制/风/潮汐/星落）、光带（x/y/diag/diagr）、
    标签（steady/blink/progress）、拼写（KLARA）、涟漪、滴答、全屏衰减
    - 交叉淡入：状态切换时混上一帧 → "加载中 → 时间"自然读作"星星聚拢成文字"
    - LUT：SIN / GAMMA 由 tools/gen_luts.py 生成，定点整数运算
    （no_std 无 powf/sinf，且保证宿主与固件逐位一致）
    - 蛇形逆映射 rc_o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
2026-10-18 fix(anim): 修正光带宽度单位（整板全亮/掉帧的根因）+ 8fps + 功率闸
    实机现象：开屏扫屏时整块板全亮、伴随掉帧闪烁；大范围点亮时亮度明显下降。
    根因：`band()` 的投影坐标是"格"（0..21），但宽度参数是从实验台带来的
    "×100 的格数"（125），函数里又直接把它当"格"用 → 实际光带宽度约 10 格，
    几乎覆盖整板。全部点亮的瞬间电流远超电源能力，WS2812 电压跌落复位，
    表现为"整板闪白 + 掉帧"。
    修正：
    - band 内部把投影坐标换成"毫格"，宽度同量纲（1250 = 1.25 格）
    - 实测峰值帧：亮格 ~20（码值 ≥8），整帧码值和 ~600（≈0.1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
2026-10-18 perf(anim): 实测瓶颈在 RMT 写入不是面板，按 5~10fps 重定标动效
    实测（ESP32-C5 + legacy RMT，clock_divider=1, mem_block_num=4）：
    - 单帧 show_rgb 线材时间只需 3.4ms，但**阻塞 20ms（系统静默）~ 175ms
    （WiFi 活跃）**
    - 原因：2737 个 RMT item 按 4 块缓冲分 ~11 段传输，每段都要等完成信号；
    WiFi 抢占把每段等待拉长到 ~15ms → 11×15 ≈ 165ms
    - 结论：面板真实可达帧率 5~10fps，不是 25fps；"亮度响应慢/间隔数百毫秒"
    就是这个阻塞造成的
    按此重定标：
    - FRAME_MS 125ms（8fps），并**跳过重复帧**（静态画面零写入）
    - 所有动效节奏改为"每步至少跨 2 帧"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
2026-10-18 fix(anim): 单帧写入回到 3.4ms（真相：debug 构建 + 脏 Flash），开屏不再定格
    结论推翻上一轮的判断——**面板没有性能问题，也不需要 DMA**：
    实测（release 构建 + 擦过 Flash）：
    - 单帧 show_rgb = **1.6~3.4ms**，正好是 114×24bit 在 800kHz 上的线材时间
    → legacy RMT 驱动已到物理上限
    - 之前的 175ms 来自两件事：**dev(debug) 构建**里 leddrv::encode() 慢几十倍，
    以及反复烧写后 **Flash 状态损坏**（NVS/PHY 分区不一致）
    处置：
    - 启动即崩循环（app_main 之前就 Guru、几十次重启）→ `espflash erase-flash`
    后重新烧写即恢复；debug/release/全量重建都复现，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
2026-10-18 docs(agents): 构建统一改为 --release（debug 会误判为硬件性能问题）
2026-10-19 fix(anim): 8fps 下只做离散切换——planet 改常亮（那个慢闪的 E）
    用户反馈两件事，其实是同一个根因：
    1. "慢呼吸在灯板上效果不好，明暗变化卡卡的"
    2. "第 9 排第 2 格那颗字母 E 一直在慢闪"
    第 2 条查出来了：那是 **planet**（暖点，坐标 (8,1) → 第 9 排第 2 格的 E，
    "SEVENTWELVE" 的首字母 E）在做 14s 呼吸。码值只在 1~7 之间变化，
    在 8bit + 8fps 的面板上就读成"慢闪"。
    统一处理（8fps 场景的唯一稳定表达方式）：
    - 新增 `Lights::quantize()`：所有 alpha 量化到 6 档
    （0/100/250/450/700/1000），抹掉一切连续 ramp
    - planet 取消呼吸，改常亮（25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
2026-10-19 fix(anim): planet 改暖白（琥珀色专用于异常语义）
    用户确认：那颗 E 已不再闪，变成低亮度常亮。但暴露出另一个语义冲突——
    planet 用的是琥珀色(tint 3)，而琥珀在本项目里专指"异常"
    （网络错误降级显示、NET/TIME 点名都用它）。开屏期间也常亮着一颗琥珀灯，
    会被读成"设备有问题"。
    - planet 颜色 3(琥珀) → 2(暖白)，与星场的偏暖档同族
    - 新增回归测试 `planet_用暖白而不是琥珀色`（Running/DeepNight/Boot/
    ProvisioningWait 四个状态都断言 tint == 2）
    - 19 项 core 测试通过；实机启动正常，运行态 写/跳=31/116（静止不重绘）
2026-10-19 fix(anim): 两个致命数值 bug（星场在固件里从未亮过）+ planet 默认关闭
    1) twinkle_spike 多除了一次 1000：
    s⁴ 的标度算错 → 所有星的 env 恒为 ~0 → **固件里整片星空从来没亮过**
    （只有时间文字、标签、planet 可见）。修好后 Running 态实测 27 颗星、
    alpha 上限 171 → 量化到 250（码值≈4，正是"星场层"）。
    2) Star.phase 溢出：`(1000 * r3) as u16` 把 0..999 放大 1000 倍再截断成
    u16（实测得到 46032），相位完全失真。改为 `(r3 % 1000) as u16`。
    3) planet 默认关闭：它没有语义，一颗常亮的孤立字母在"报时/加载"里会被
    读成坏灯。现在**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
2026-11-07 fix(firmware): N32R8 板子的 flash 配置（32MB + 40MHz）与分区表
    换到新板 ESP32-C5-WROOM-1-N32R8（32MB flash）后，按旧板默认值编出来的固件
    一烧上去就是 `Guru Meditation (Illegal instruction)` 无限重启，崩在
    call_start_cpu0 → esp_mmu_map_init —— 恰好是 flash 时钟切换后执行的第一段
    flash 常驻代码。
    排查依据（细节留档在 firmware/README.md「板子差异」）：
    - 不是镜像/烧录问题：flash 内容与镜像 1.46MB 逐字节一致（仅末尾 hash 差异）
    - 不是代码问题：debug 版、`--features diag` 小包都能正常启动，只有 release
    全量包中招——很容易被"debug 能跑"误判成代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
2026-11-07 feat(web): 设备主机名可配（DHCP option 12），默认 klara-clock
    接入 WLAN 后路由器客户端列表里一直显示 IDF 的默认名 "espressif"
    （`CONFIG_LWIP_LOCAL_HOSTNAME` 的默认值，我们从没设过 hostname）。
    改动：
    - settings.rs：新增 `name` 字段（NVS 键 `name`，默认 klara-clock）+ `sanitize_hostname()`
    —— 小写化、非法字符折叠成单个 `-`、去首尾 `-`、截断 32、空则回落默认值。
    `esp_netif_set_hostname` 不做任何校验，坏名字会被路由器丢弃或显示成乱码；
    中文/emoji 只适合进显示名，不在主机名规范内
    - wifi.rs：`set_hostname()` 用 `esp_netif_set_hostname(sta_netif)`；
    IDF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
2026-11-07 feat(mdns): 局域网域名访问 klara-clock.local
    上一版只上报 DHCP option 12 主机名，但很多家用网关（本机实测的 ctOS 就是不登记
    的那个）不把 DHCP 名字写进 DNS，`ping klara-clock` 解析不了。补上 mDNS 后
    Windows / macOS / iOS / Linux(Avahi) 都能直接用 http://klara-clock.local/ 访问。
    要点：IDF v5.5 起 mdns 已从内置组件移到组件仓库，引入方式不是改 sdkconfig 就完事：
    - app/Cargo.toml 用 `[package.metadata.esp-idf-sys] extra_components` 声明
    `espressif/mdns`（^1），esp-idf-sys 生成 idf_component.yml 交给 IDF 组件管理器
    - 版本锁进 firmware/components_esp32c5.lock（1.15.1），与 Cargo.lock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
2026-11-07 chore(git): 忽略 Windows Zone.Identifier 附属流与 KiCad 锁文件
    Windows 上复制/下载的文件会带 "xxx.jpg:Zone.Identifier" 这种 ADS 附属流，
    KiCad 编辑中会留下 "~<project>.kicad_*.lck"，都不是仓库应该收纳的内容。
2026-11-07 feat(enclosure): v4 结构 —— 按实物重测重画 + 实测留档
    之前 v3（scad/wordclock_pcb.scad）是按 EasyEDA 的 STEP 模型推的尺寸，实机装配时
    发现装不上，2026-10 对实物重新测量后得出修正值，工作目录里一直没提交：
    - 灯板 **192×202×2.0**（旧文档 192×192×1.6）：Y 向多出两块各 5mm V-CUT 工艺边
    - 灯阵 11×10 @pitch 15，**gy=26**（旧 21）；角点 Y=12（旧 7）；4×M3 孔 Y=11（旧 6）
    - C117 电解中心 (148.5, 185.5)、高出板面 **12.0**（旧 11.5 @ (146,11.5)）
    - 排针座高 8.0（旧 8.54）；DevKit **61.7**（旧 53.6）；USB-C 母口改为 14×20 转接板
    - 映射关系：Y_物理 = 197 −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
2026-11-07 chore(hardware): fab/pcba.step 不入库（与 pcba.step 字节一致）
    fab 包里那份 STEP 只是 ../pcba.step 的拷贝（md5 相同、8.4MB），提交会在历史里
    塞进第二份同样的二进制。改为 .gitignore 排除，并在 README 里写明
    「要自洽的 fab 包时手动 cp pcba.step fab/」。
